AaronJackson/TrainDepartureBoard-Discord/README.md

# Discord on a Train Departure Board

Still a work in progress.

https://wiki.nottinghack.org.uk/wiki/Train_Station_Display
