AaronJackson/TrainDepartureBoard-Discord/pcb/tdb-distributor/tdb-distributor.kicad_pcb

## KiCad design pcb/tdb-distributor/tdb-distributor.kicad_pcb (2024-12-19)

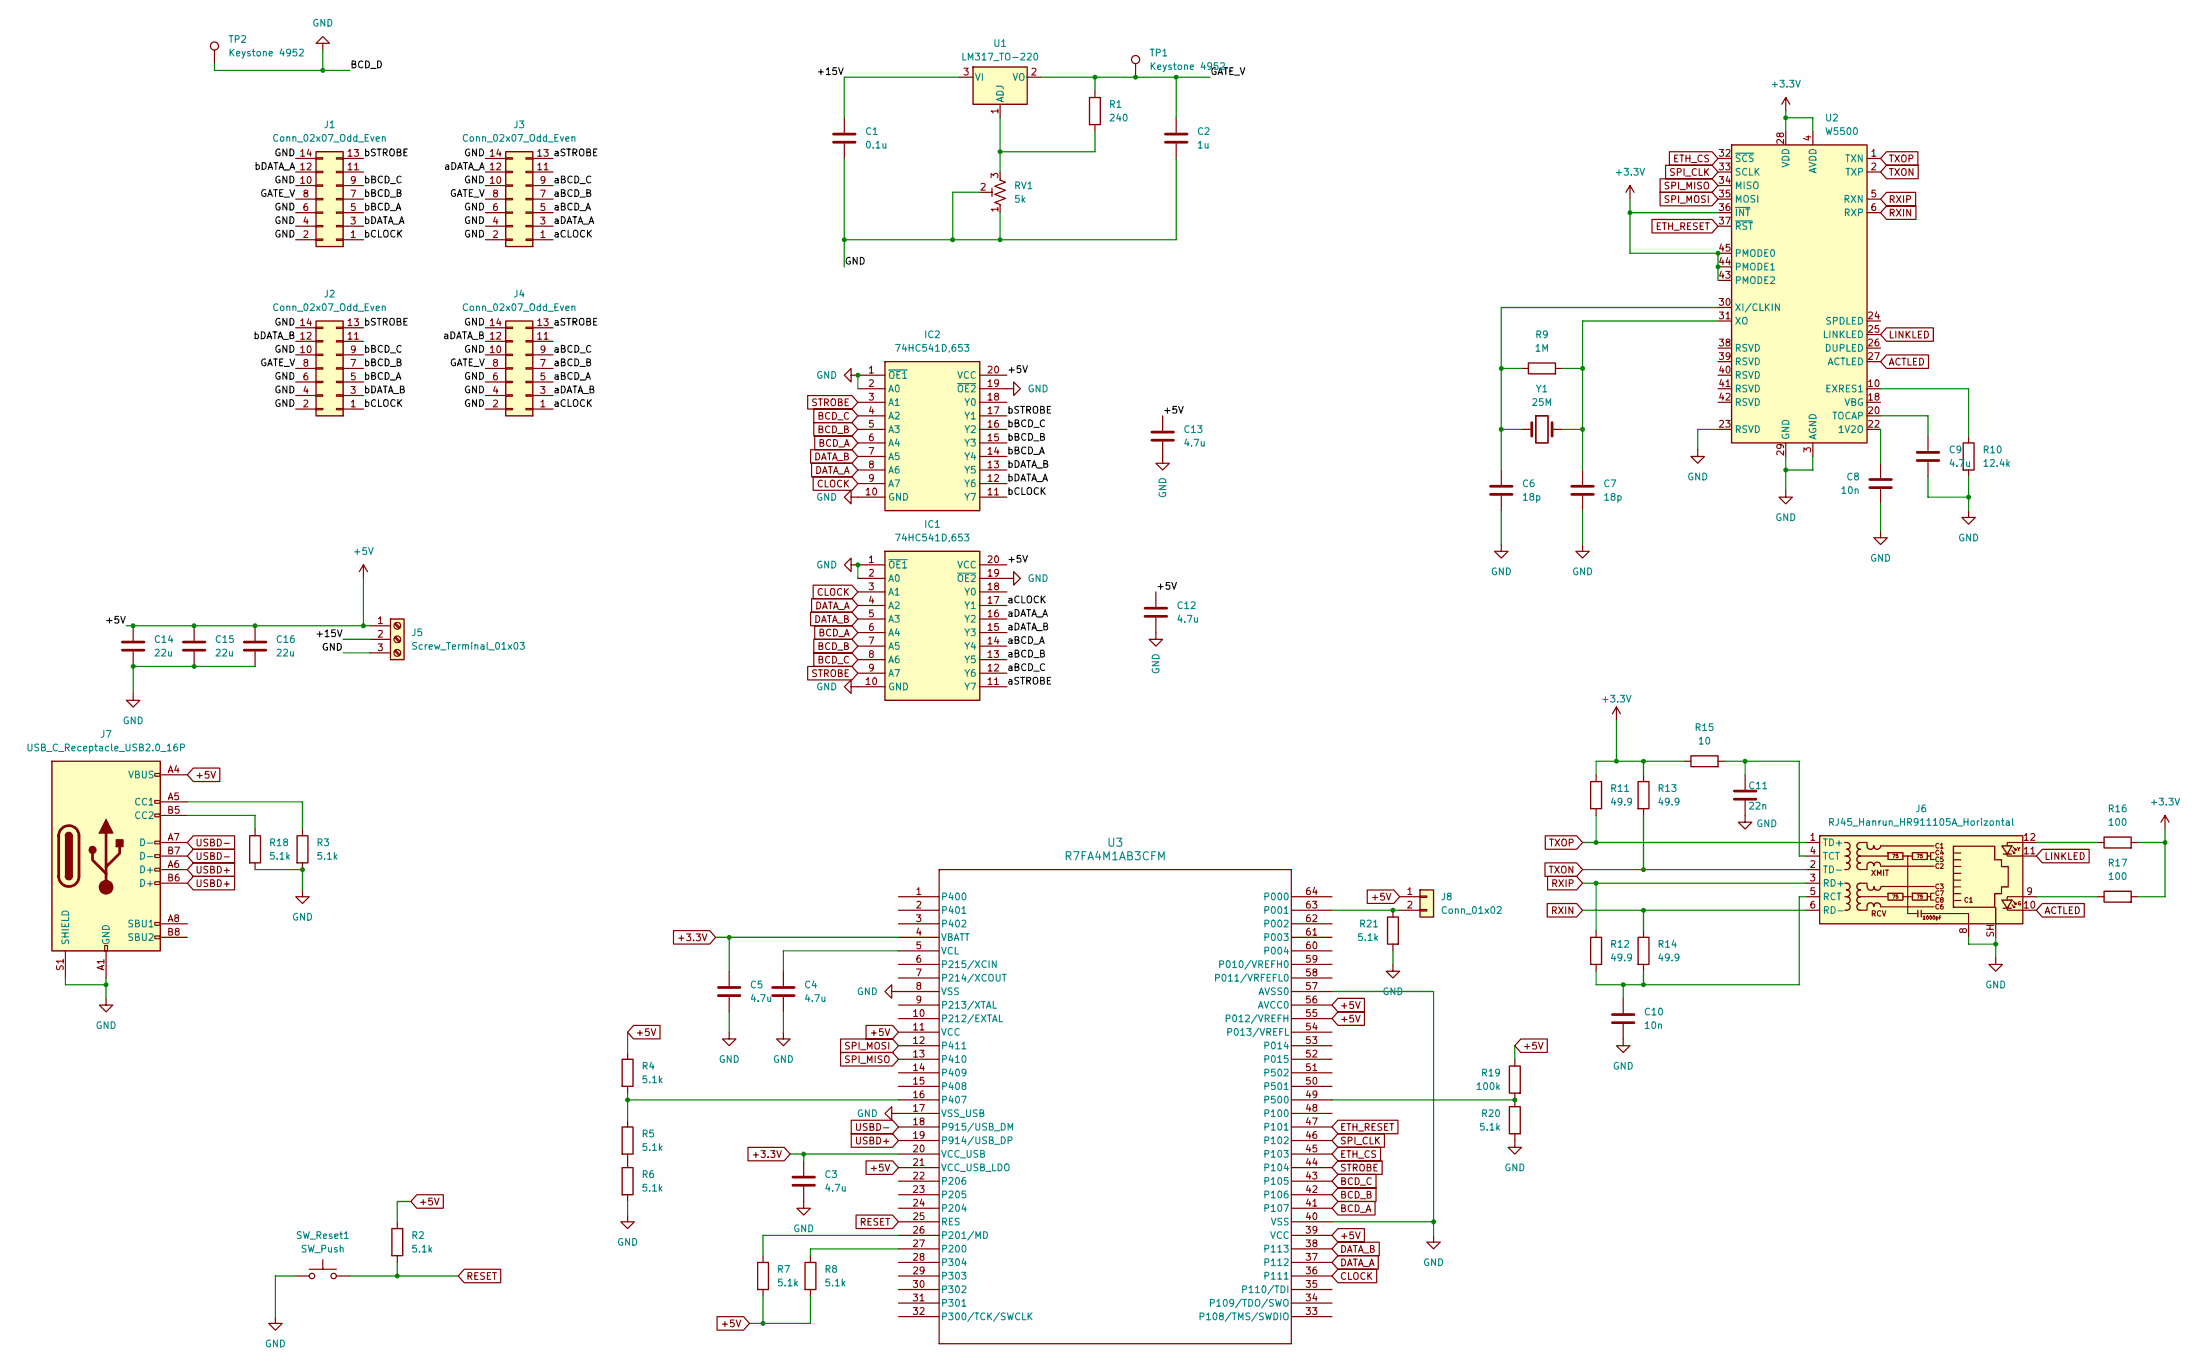
[picture p1: schematic tdb-distributor.kicad_sch]

Parts:
C1: 0.1u; C_0603_1608Metric
C2: 1u; C_0603_1608Metric
C3, C4, C5, C9, C12, C13: 4.7u; C_0603_1608Metric
C6, C7: 18p; C_0603_1608Metric
C8, C10: 10n; C_0603_1608Metric
C11: 22n; C_0603_1608Metric
C14, C15, C16: 22u; C_0603_1608Metric
IC1, IC2: 74HC541D,653; SOIC-20W_7.5x12.8mm_P1.27mm; Manufacturer_Part_Number 74HC541D,653
J1, J2, J3, J4: Conn_02x07_Odd_Even; IDC-Header_2x07_P2.54mm_Vertical
J5: Screw_Terminal_01x03; TerminalBlock_WAGO_236-103_1x03_P5.00mm_45Degree
J6: RJ45_Hanrun_HR911105A_Horizontal
J7: USB_C_Receptacle_USB2.0_16P; USB_C_Receptacle_G-Switch_GT-USB-7010ASV
J8: Conn_01x02; PinHeader_1x02_P2.54mm_Vertical
R1: 240; R_0603_1608Metric
R2, R3, R4, R5, R6, R7, R8, R18, R20, R21: 5.1k; R_0603_1608Metric
R9: 1M; R_0603_1608Metric
R10: 12.4k; R_0603_1608Metric
R11, R12, R13, R14: 49.9; R_0603_1608Metric
R15: 10; R_0603_1608Metric
R16, R17: 100; R_0603_1608Metric
R19: 100k; R_0603_1608Metric
RV1: 5k; Potentiometer_Runtron_RM-065_Vertical
SW_Reset1: SW_Push; SW_TH_Tactile_Omron_B3F-10xx
TP1, TP2: Keystone 4952; TestPoint_THTPad_2.5x2.5mm_Drill1.2mm
U1: LM317_TO-220; TO-220-3_Vertical
U2: W5500; LQFP-48_7x7mm_P0.5mm
U3: R7FA4M1AB3CFM; PLQP0064KB-C_REN
Y1: 25M; Crystal_SMD_5032-2Pin_5.0x3.2mm

Connections:
+3.3V: C3.1, C5.1, R11.1, R13.1, R15.1, R16.2, R17.2, U2.4 (AVDD), U2.8 (AVDD), U2.11 (AVDD), U2.15 (AVDD), U2.17 (AVDD), U2.21 (AVDD), U2.28 (VDD), U2.36 (~INT), U2.43 (PMODE2), U2.44 (PMODE1), U2.45 (PMODE0), U3.4 (VBATT), U3.20 (VCC_USB)
+5V: C12.1, C13.1, C14.1, C15.1, C16.1, IC1.20 (VCC), IC2.20 (VCC), J5.1, J7.A4 (VBUS), J7.A9 (VBUS), J7.B4 (VBUS), J7.B9 (VBUS), J8.1, R2.1, R4.1, R7.2, R8.2, R19.1, U3.11 (VCC), U3.21 (VCC_USB_LDO), U3.39 (VCC), U3.55 (P012/VREFH), U3.56 (AVCC0)
/+15V: C1.1, J5.2, U1.3 (VI)
/GATE_V: C2.1, J1.8, J2.8, J3.8, J4.8, R1.1, TP1.1, U1.2 (VO)
/aBCD_A: IC1.14 (Y4), J3.5, J4.5
/aBCD_B: IC1.13 (Y5), J3.7, J4.7
/aBCD_C: IC1.12 (Y6), J3.9, J4.9
/aCLOCK: IC1.17 (Y1), J3.1, J4.1
/aDATA_A: IC1.16 (Y2), J3.3, J3.12
/aDATA_B: IC1.15 (Y3), J4.3, J4.12
/aSTROBE: IC1.11 (Y7), J3.13, J4.13
/bBCD_A: IC2.14 (Y4), J1.5, J2.5
/bBCD_B: IC2.15 (Y3), J1.7, J2.7
/bBCD_C: IC2.16 (Y2), J1.9, J2.9
/bCLOCK: IC2.11 (Y7), J1.1, J2.1
/bDATA_A: IC2.12 (Y6), J1.3, J1.12
/bDATA_B: IC2.13 (Y5), J2.3, J2.12
/bSTROBE: IC2.17 (Y1), J1.13, J2.13
ACTLED: J6.10, U2.27 (ACTLED)
BCD_A: IC1.6 (A4), IC2.6 (A4), U3.41 (P107)
BCD_B: IC1.7 (A5), IC2.5 (A3), U3.42 (P106)
BCD_C: IC1.8 (A6), IC2.4 (A2), U3.43 (P105)
CLOCK: IC1.3 (A1), IC2.9 (A7), U3.36 (P111)
DATA_A: IC1.4 (A2), IC2.8 (A6), U3.37 (P112)
DATA_B: IC1.5 (A3), IC2.7 (A5), U3.38 (P113)
ETH_CS: U2.32 (~SCS), U3.45 (P103)
ETH_RESET: U2.37 (~RST), U3.47 (P101)
GND: C1.2, C2.2, C3.2, C4.2, C5.2, C6.2, C7.2, C8.2, C9.2, C10.1, C11.2, C12.2, C13.2, C14.2, C15.2, C16.2, IC1.1 (~OE1), IC1.2 (A0), IC1.10 (GND), IC1.19 (~OE2), IC2.1 (~OE1), IC2.2 (A0), IC2.10 (GND), IC2.19 (~OE2), J1.2, J1.4, J1.6, J1.10, J1.14, J2.2, J2.4, J2.6, J2.10, J2.14, J3.2, J3.4, J3.6, J3.10, J3.14, J4.2, J4.4, J4.6, J4.10, J4.14, J5.3, J6.8, J6.SH, J7.A1 (GND), J7.A12 (GND), J7.B1 (GND), J7.B12 (GND), J7.S1 (SHIELD), R3.2, R6.2, R10.2, R18.2, R20.2, R21.2, RV1.1, RV1.2, SW_Reset1.1, TP2.1, U2.3 (AGND), U2.9 (AGND), U2.14 (AGND), U2.16 (AGND), U2.19 (AGND), U2.23 (RSVD), U2.29 (GND), U2.48 (AGND), U3.8 (VSS), U3.17 (VSS_USB), U3.40 (VSS), U3.57 (AVSS0)
LINKLED: J6.11, U2.25 (LINKLED)
unnamed: J6.9, R17.1
unnamed: J6.12, R16.1
unnamed: C10.2, J6.5 (RCT), R12.2, R14.2
unnamed: C11.1, J6.4 (TCT), R15.2
unnamed: J7.A5 (CC1), R3.1
unnamed: J7.B5 (CC2), R18.1
unnamed: J8.2, R21.1, U3.63 (P001)
unnamed: R5.2, R6.1
unnamed: R1.2, RV1.3, U1.1 (ADJ)
unnamed: C8.1, U2.22 (1V2O)
unnamed: R10.1, U2.10 (EXRES1)
unnamed: C9.1, U2.20 (TOCAP)
unnamed: C6.1, R9.1, U2.30 (XI/CLKIN), Y1.1
unnamed: C7.1, R9.2, U2.31 (XO), Y1.2
unnamed: R8.1, U3.27 (P200)
unnamed: R7.1, U3.26 (P201/MD)
unnamed: R4.2, R5.1, U3.16 (P407)
unnamed: R19.2, R20.1, U3.49 (P500)
unnamed: C4.1, U3.5 (VCL)
RESET: R2.2, SW_Reset1.2, U3.25 (RES)
RXIN: J6.6 (RD-), R14.1, U2.6 (RXP)
RXIP: J6.3 (RD+), R12.1, U2.5 (RXN)
SPI_CLK: U2.33 (SCLK), U3.46 (P102)
SPI_MISO: U2.34 (MISO), U3.13 (P410)
SPI_MOSI: U2.35 (MOSI), U3.12 (P411)
STROBE: IC1.9 (A7), IC2.3 (A1), U3.44 (P104)
TXON: J6.2 (TD-), R13.2, U2.2 (TXP)
TXOP: J6.1 (TD+), R11.2, U2.1 (TXN)
USBD+: J7.A6 (D+), J7.B6 (D+), U3.19 (P914/USB_DP)
USBD-: J7.A7 (D-), J7.B7 (D-), U3.18 (P915/USB_DM)

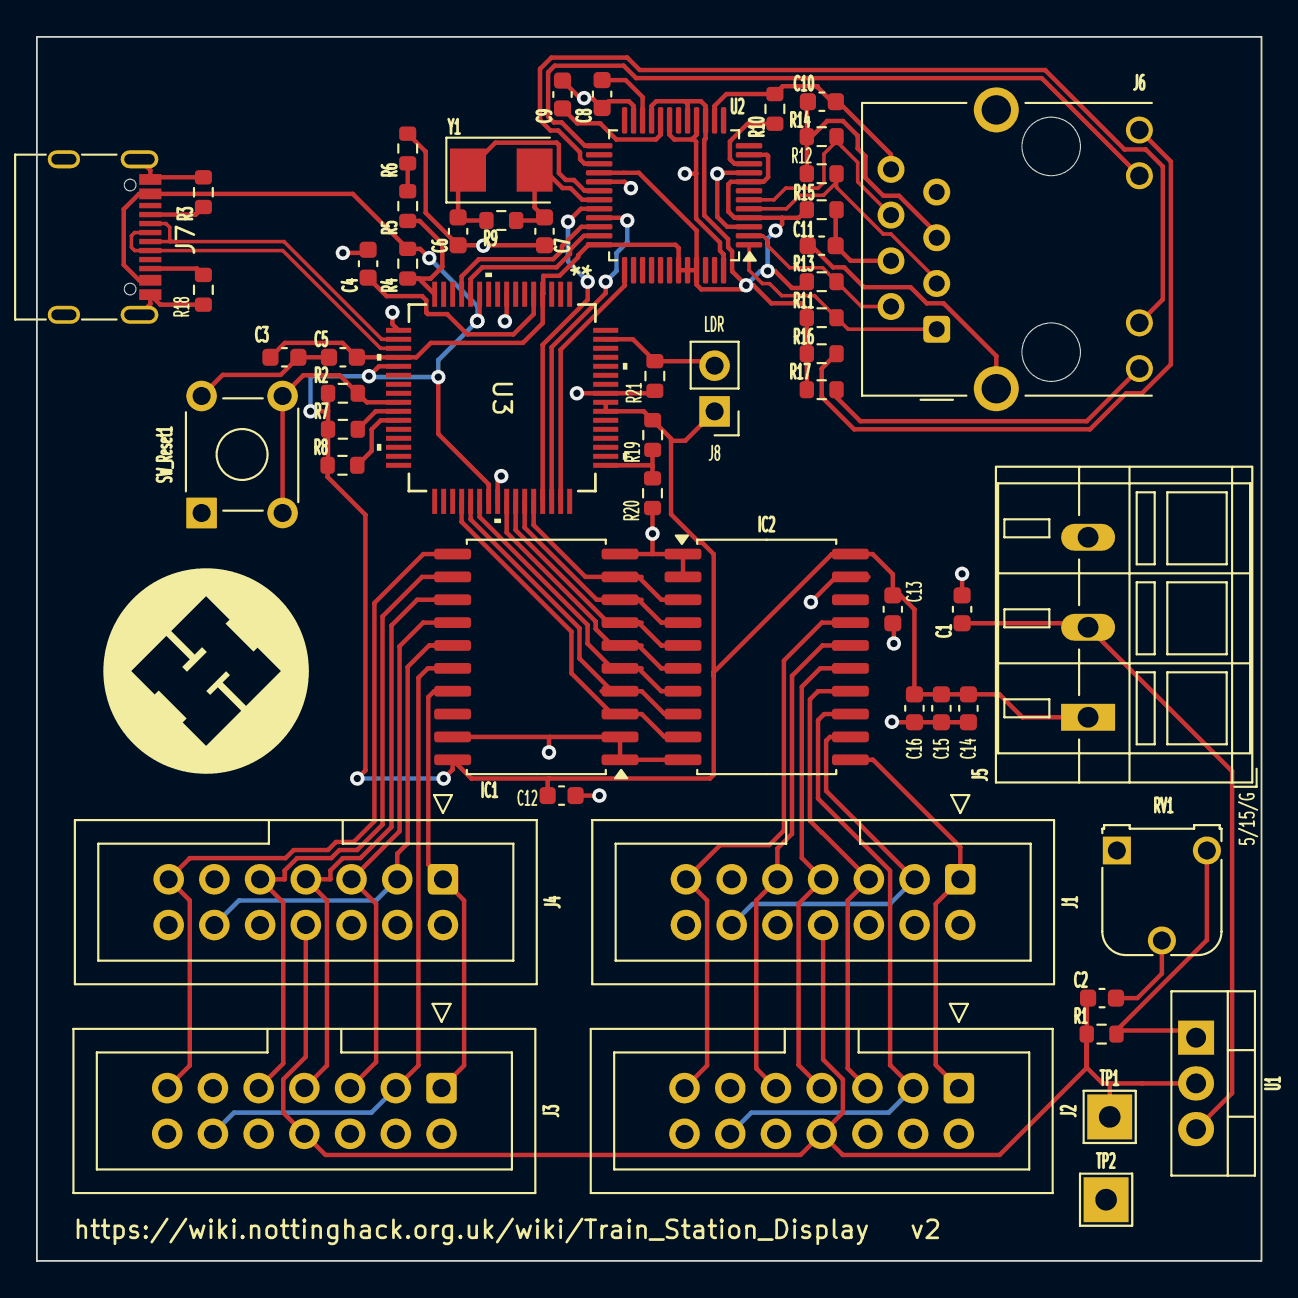
[picture p2: board tdb-distributor.kicad_pcb from above]

Board: 2 copper layers, 68.0 x 68.0 mm, 55 parts (0 on the bottom side), 59 nets.
