AaronJackson/TrainDepartureBoard-Discord/(commit log)

2024-02-14 Version 1 of PCB
    [tdb-distributor.kicad_pcb, tdb-distributor.kicad_sch]
2024-02-14 Add labels to power input
    [tdb-distributor.kicad_pcb]
2024-02-15 kicad gitignore
2024-03-02 Replace delayMicroseconds(1) with three NOPs
    [dispcord-r4.ino]
2024-03-02 Raw buffer access to avoid rotation and index checking
    [dispcord-r4.ino]
2024-03-02 Split inner bit banging loop to avoid modulo
    [dispcord-r4.ino]
2024-03-17 Switch to interrupt driven drawing
    This change is pretty disgusting but an interrupt > 50uS is likely to
    cause the WiFi or TCP connection to drop. I think this is due to the
    WiFi connection on an Uno R4 being driven over UART, which itself
    requires interrupts. Anyway, breaking this into smaller segments seems
    to avoid it crashing, and still allows for a framerate of > 150fps,
    without the occasionally blip caused by mqtt.loop().
    Yet to be tested on an actual departure board.
    [dispcord-r4.ino]
2024-03-18 Add additional NOPs to PULSE
    This is required now that it's being drawn from an ISR. Presumably
    UART / WiFi interrupts were frequent enough to slow the drawBuffer
    routine down enough.
2024-03-18 Slow down the drawBufferISR timer
2024-12-19 Board redesign
    Includes R7 MPU and WizNet
    Adds buffer chips to hopefully support both sides of the display
    [tdb-distributor.kicad_pcb, tdb-distributor.kicad_sch]
2024-12-19 minor drc cleanup
    [tdb-distributor.kicad_pcb]
2024-12-21 Update pinout to reflect PCB v2
2025-01-01 Changes for board v2
